logos-electromechanical/Arachnio/Arachnio/images/Arachnio-pinout.png

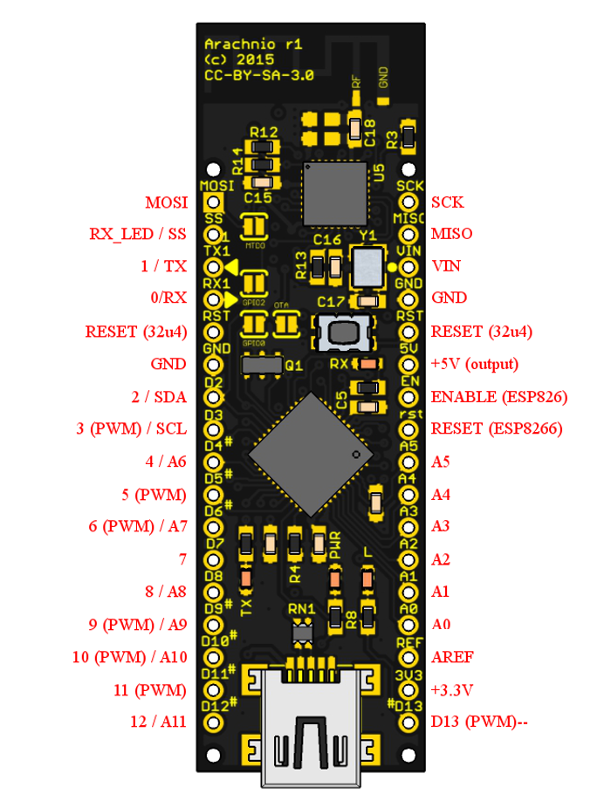
Arachnio/images/Arachnio-pinout.png
