logos-electromechanical/Arachnio/images/arachnio-proto-top.png

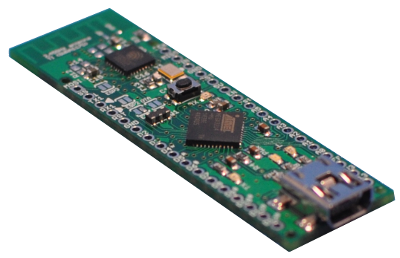
images/arachnio-proto-top.png
