logos-electromechanical/Arachnio/README.md

# Arachnio
An Arduino Micro variant with integrated WiFi
