logos-electromechanical/Arachnio/Arachnio/images/Arachnio-bot.jpg

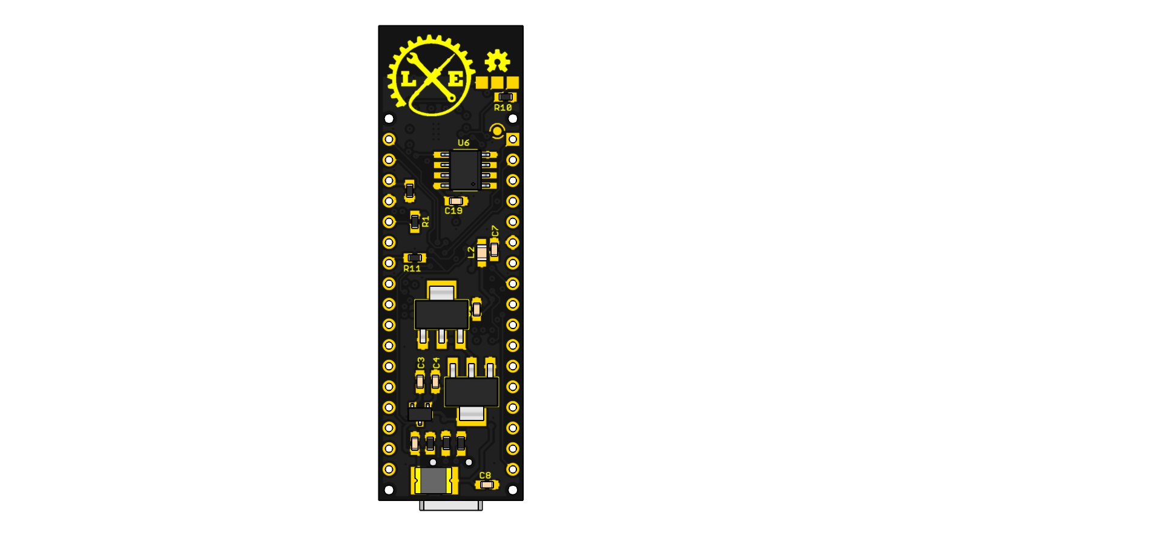
Arachnio/images/Arachnio-bot.jpg
