logos-electromechanical/Arachnio/Arachnio/images/Arachnio-iso-2.jpg

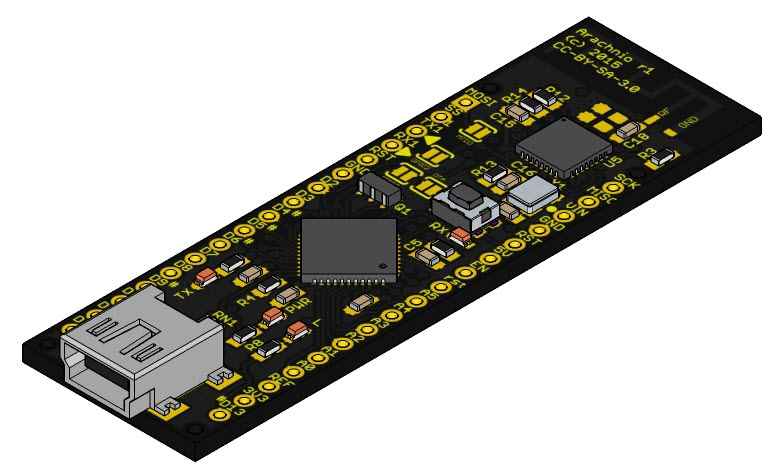
Arachnio/images/Arachnio-iso-2.jpg
