logos-electromechanical/Arachnio/Arachnio/images/Arachnio-iso.jpg

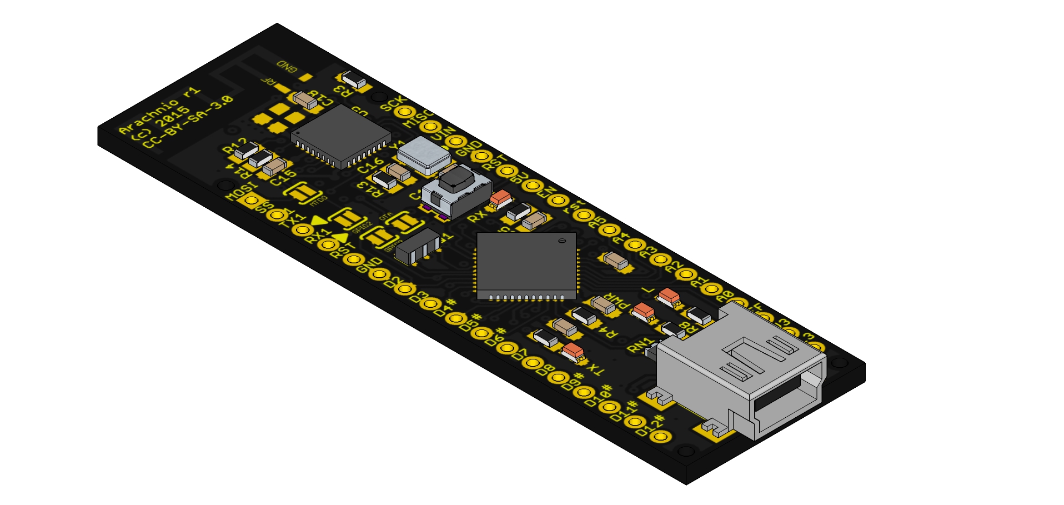
Arachnio/images/Arachnio-iso.jpg
