logos-electromechanical/Arachnio/Arachnio/images/Arachnio-pinout.jpg

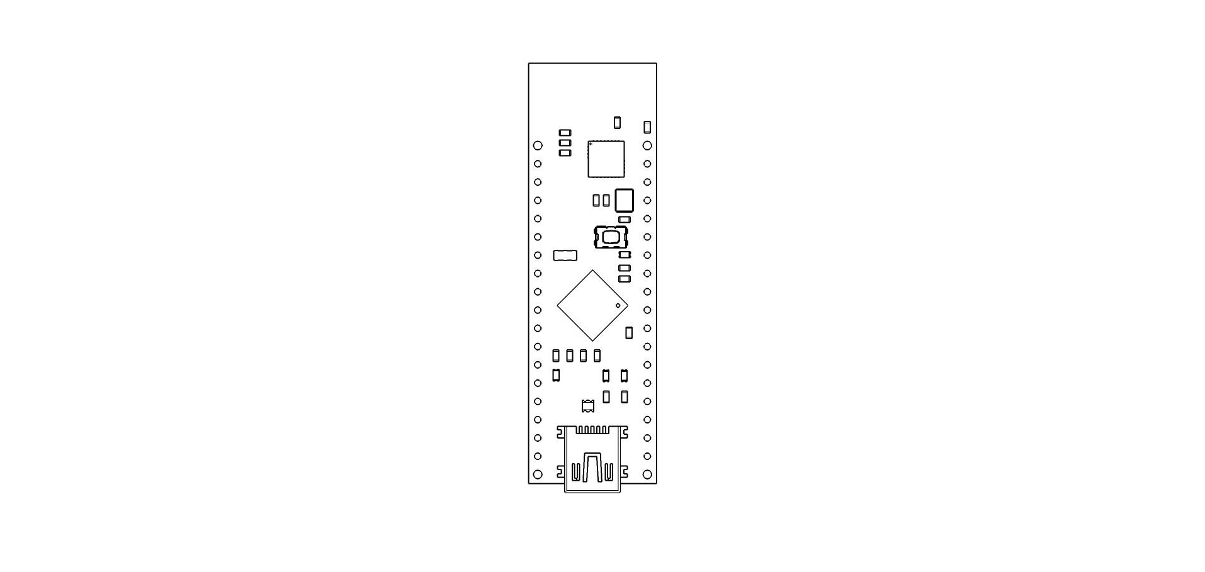
Arachnio/images/Arachnio-pinout.jpg
