logos-electromechanical/Arachnio/Arachnio/images/arachnio-single-top.jpg

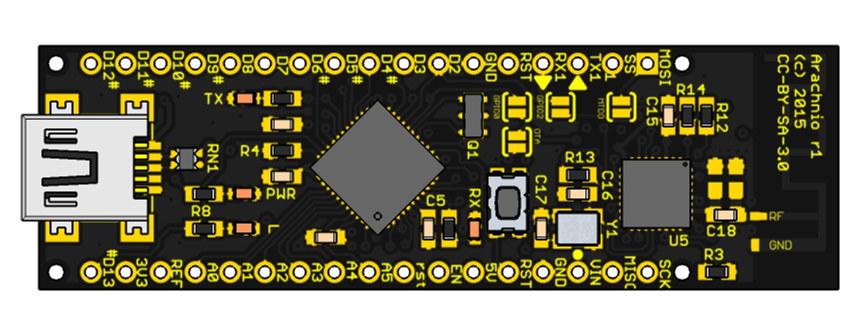
Arachnio/images/arachnio-single-top.jpg
