logos-electromechanical/Arachnio/Arachnio/images/eagleUp_Throwieduino-1_board_bottom.png

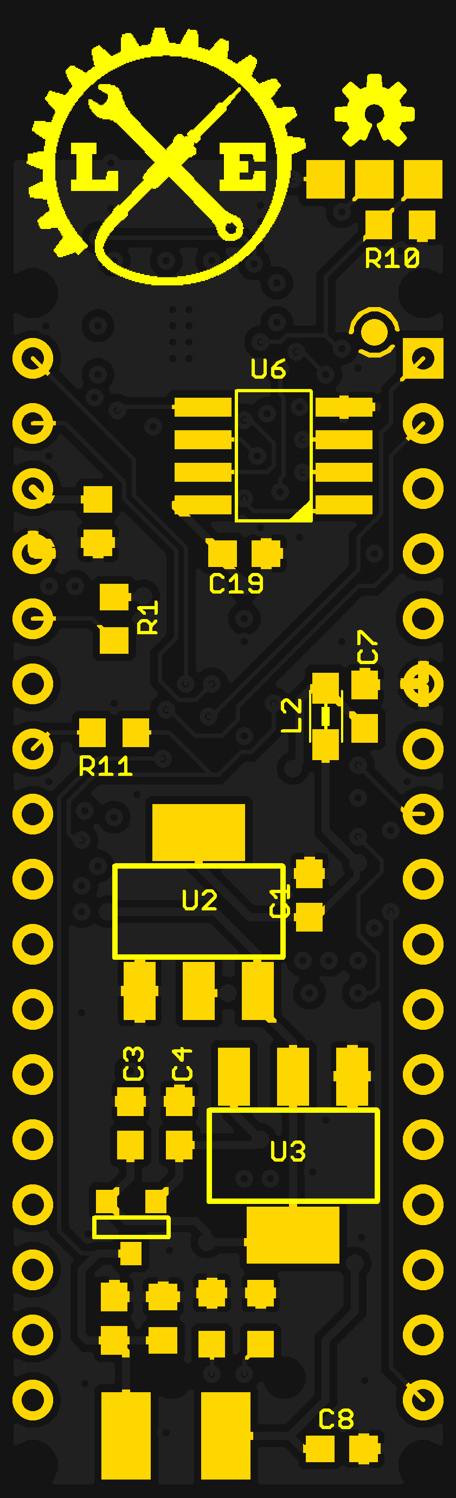
Arachnio/images/eagleUp_Throwieduino-1_board_bottom.png
