logos-electromechanical/Arachnio/Arachnio/images/eagleUp_Throwieduino-1_board_top.png

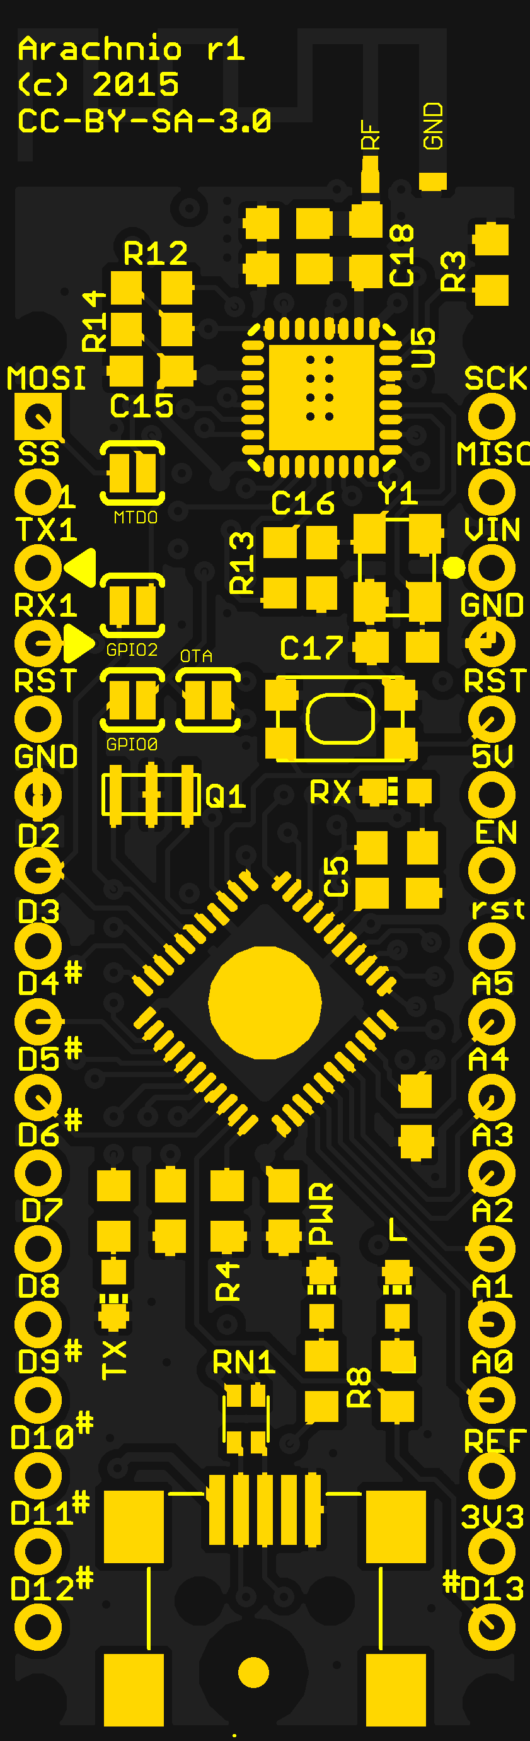
Arachnio/images/eagleUp_Throwieduino-1_board_top.png
