logos-electromechanical/Arachnio/Arachnode/images/Arachnode-iso.jpg

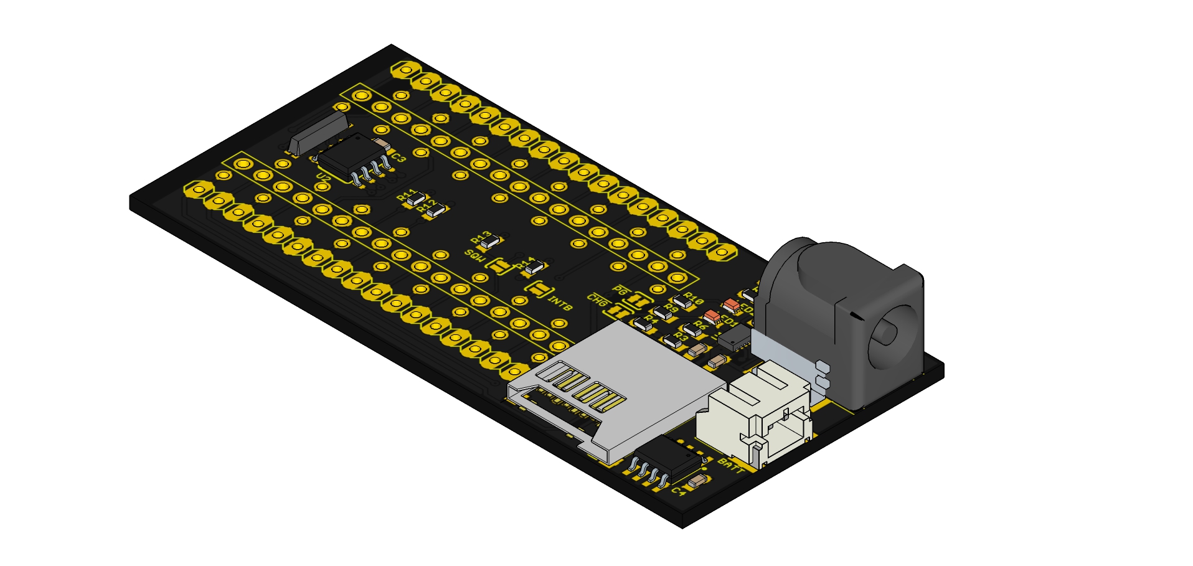
Arachnode/images/Arachnode-iso.jpg
