logos-electromechanical/Arachnio/Arachnode/images/Arachnode-top.jpg

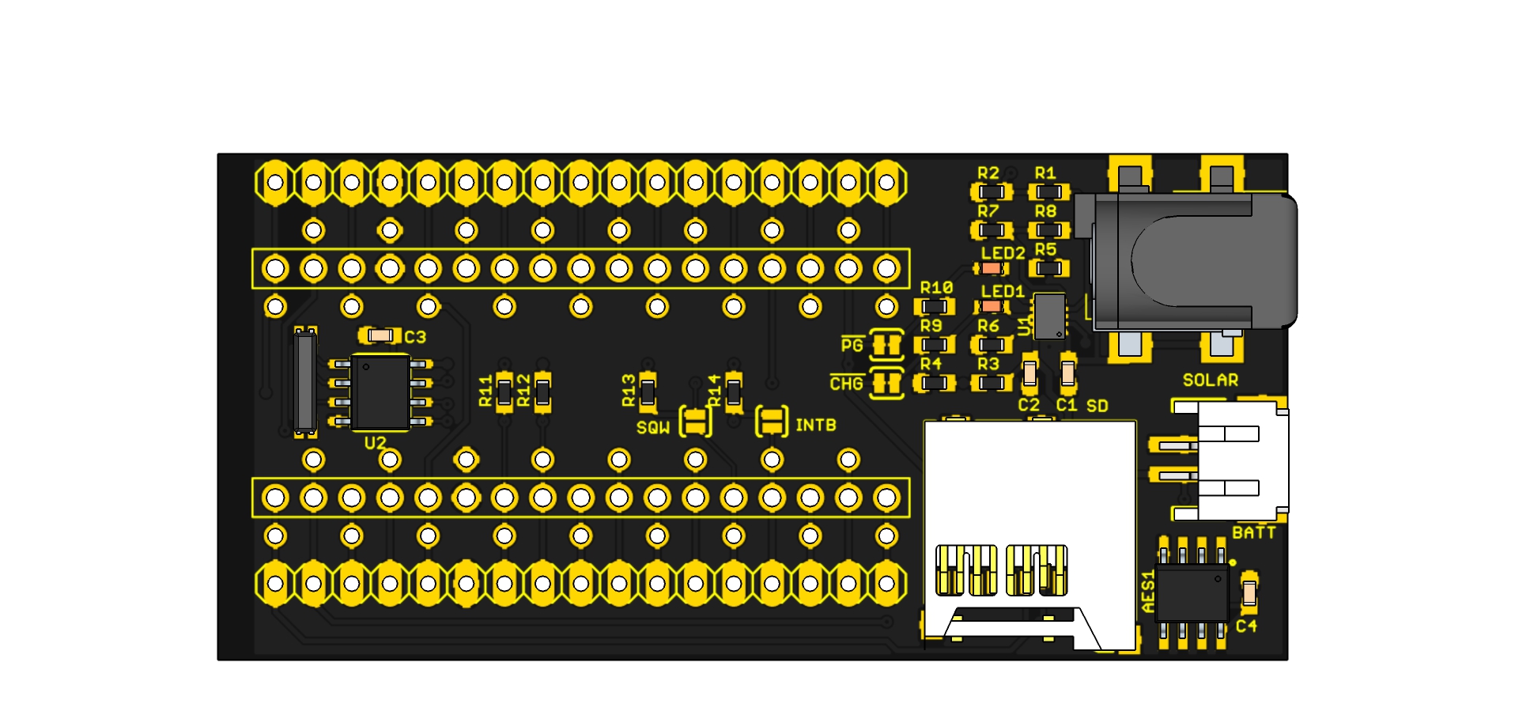
Arachnode/images/Arachnode-top.jpg
