logos-electromechanical/Arachnio/ArachnoProto/images/ArachnoProto-iso.jpg

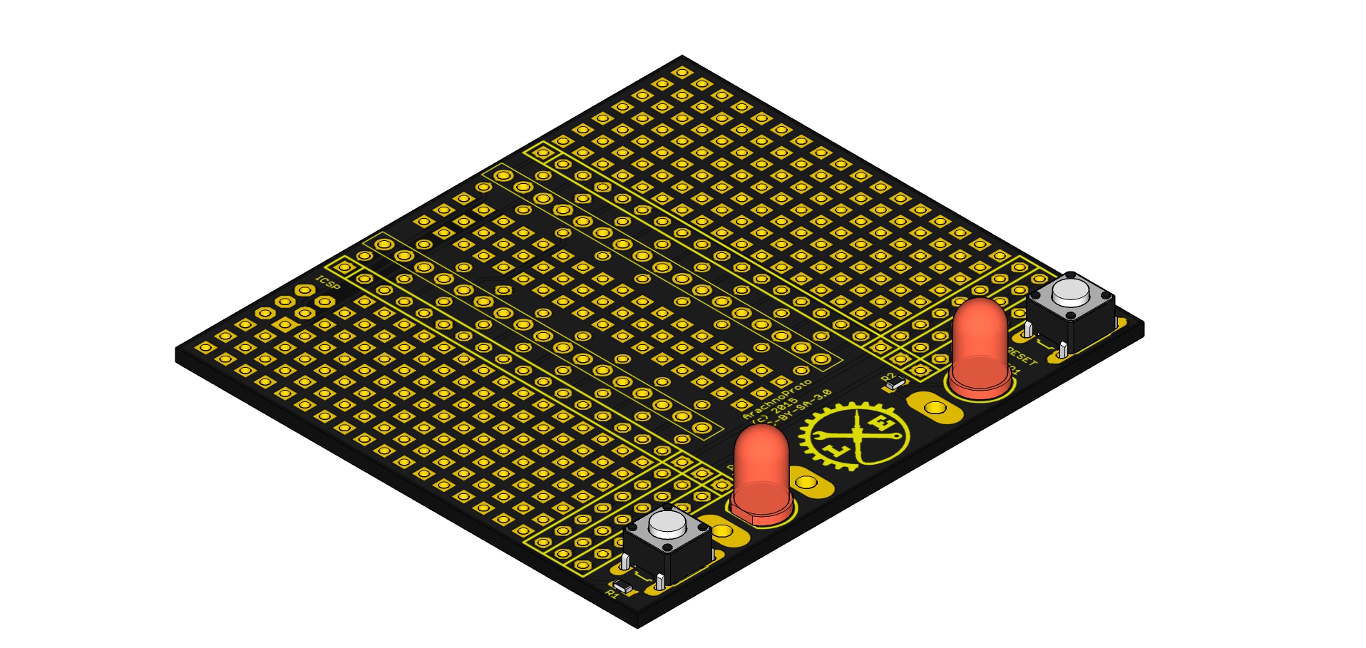
ArachnoProto/images/ArachnoProto-iso.jpg
