logos-electromechanical/Arachnio/ArachnoProto/images/ArachnoProto-top.jpg

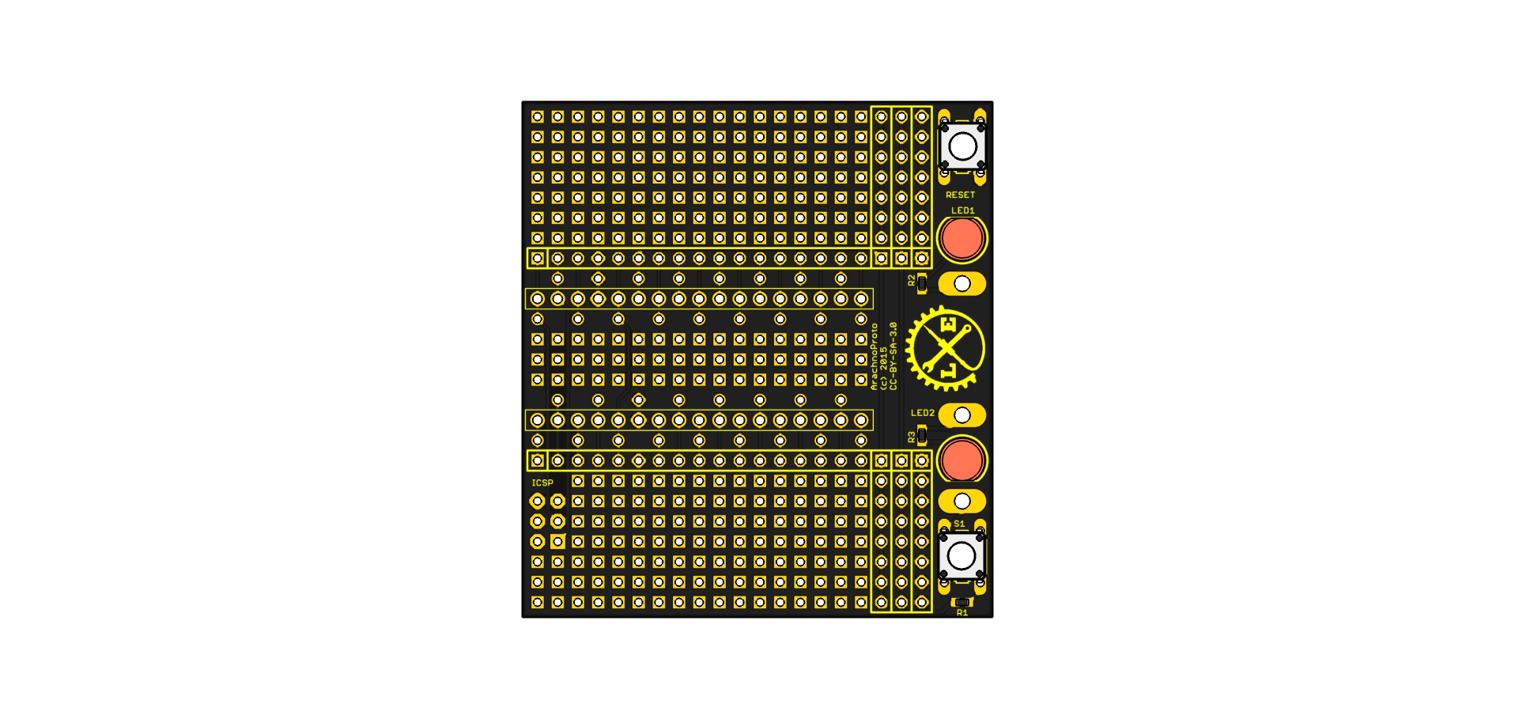
ArachnoProto/images/ArachnoProto-top.jpg
