logos-electromechanical/Arachnio/images/arachnio-double-top.png

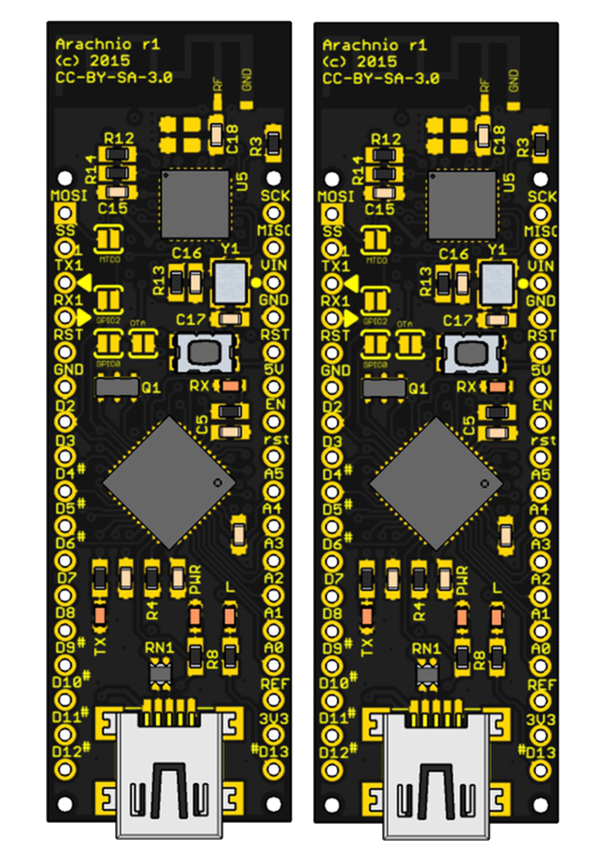
images/arachnio-double-top.png
