logos-electromechanical/Arachnio/images/arachnio-proto-bottom.png

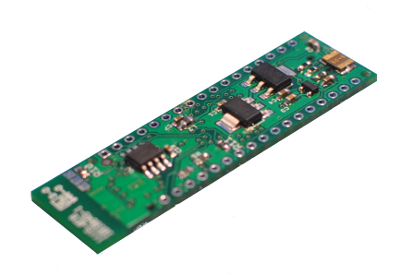
images/arachnio-proto-bottom.png
