logos-electromechanical/Arachnio/images/arachnode-rc-1.png

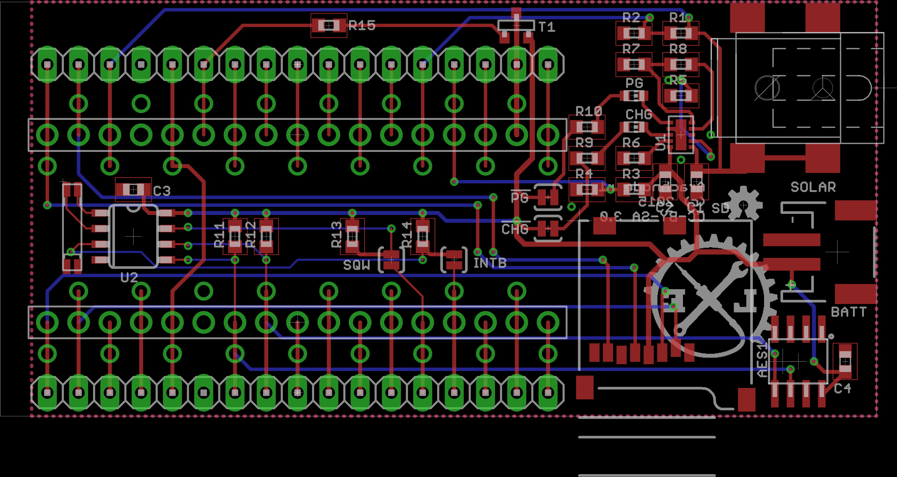
images/arachnode-rc-1.png
