logos-electromechanical/Arachnio/images/arachnoproto-rc-1.png

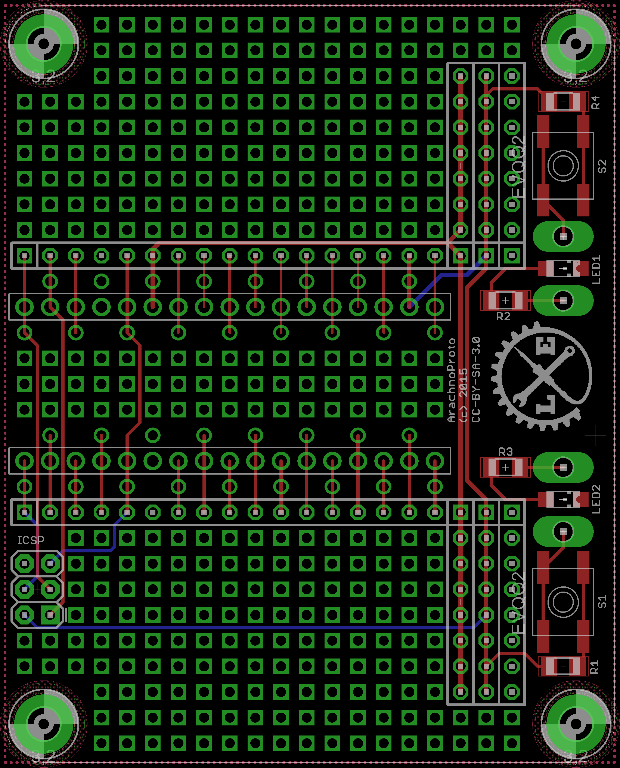
images/arachnoproto-rc-1.png
