logos-electromechanical/Arachnio/(list of files, cad)

Other CAD files:
Arachnio/hardware/eagleUp/Arachnio.skp
ArachnoProto/hardware/eagleUp/ArachnoProto.skp
Arachnode/hardware/eagleUp/Arachnode.skp
