logos-electromechanical/Arachnio/Arachnode/hardware/Arachnode.brd

## EAGLE design Arachnode/hardware/Arachnode.brd (2015-10-17)

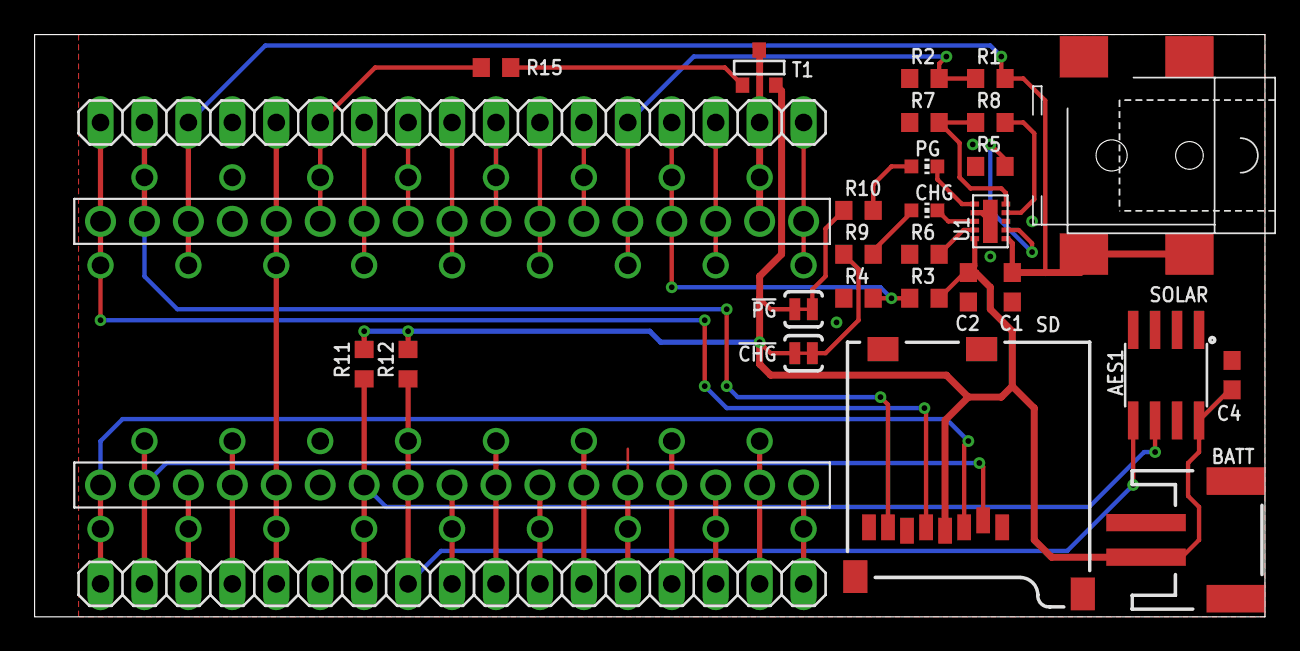
[picture p18: board Arachnode.brd from above]

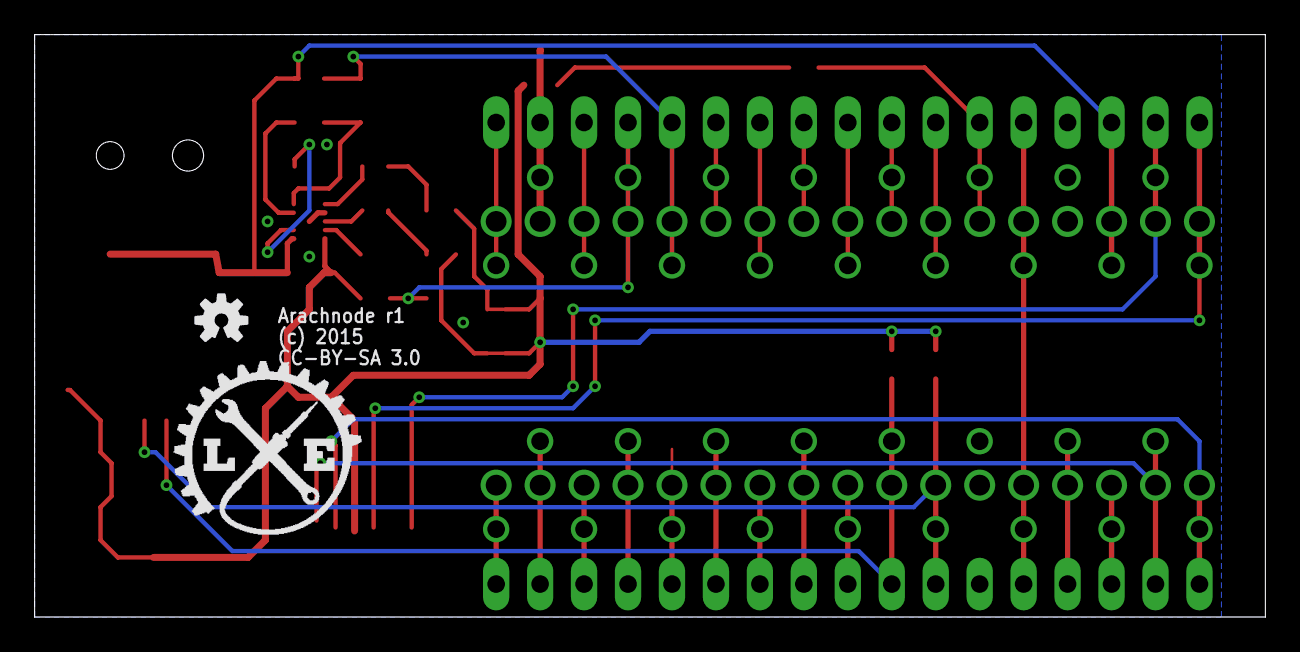
[picture p19: board Arachnode.brd from below]

Board: 2 copper layers, 71.1 x 33.7 mm, 32 parts (2 on the bottom side), 44 nets.

Parts:
!CHG!: JUMPER-PAD-2-NC_BY_TRACE; PAD-JUMPER-2-NC_BY_TRACE_YES_SILK
!PG!: JUMPER-PAD-2-NC_BY_TRACE; PAD-JUMPER-2-NC_BY_TRACE_YES_SILK
AES1: ATAES132; SOIC8
BATT: JST-2-SMD
C1, C2: 1.0uF; C0603
C4: 100n; C0603
CHG: CHIP-LED0603
J1, J2: PINHEAD-17-REV; 4UCONN-12573
JP1, JP2: 1X17
PG: CHIP-LED0603
R1, R3: 2M; R0603
R2, R4: 1M; R0603
R5: 820R; R0603
R6: 4K7; R0603
R7: 33k; R0603
R8: 68k; R0603
R9, R10: 10K; R0603
R11, R12, R15: 4k7; R0603
SD: USD-SOCKETNEW; MICRO-SD-SOCKET-PP
SOLAR: PJ002A-SMT
T1: SOT-23
U1: BQ24210; WSON-10
U$1: OSHW-LOGO-S
U$2: LOGO-SM

Connections:
3V3: J2.16, J2.33, JP2.16, T1.1
+5V: J2.6, J2.23, JP2.6, R15.2
A0: J2.14, J2.31, JP2.14, R3.1, R4.2
A1: J2.13, J2.30, JP2.13, R1.1, R2.2
A2: J2.12, J2.29, JP2.12
A3: J2.11, J2.28, JP2.11
A4: J2.10, J2.27, JP2.10
A5: J2.9, J2.26, JP2.9
AREF: J2.15, J2.32, JP2.15
D0: J1.4, J1.21, JP1.4
D1: J1.3, J1.20, JP1.3
D4: J1.9, J1.26, JP1.9
D5: J1.10, J1.27, JP1.10
D6: J1.11, J1.28, JP1.11
D7: J1.12, J1.29, JP1.12
ESP_RST: J2.8, J2.25, JP2.8
GND: AES1.4, BATT.1, BATT.NC1, BATT.NC2, C1.1, C2.1, C4.2, J1.6, J1.23, J2.4, J2.21, JP1.6, JP2.4, R2.1, R4.1, R5.1, R6.1, R7.1, SD.6, SD.CD1, SD.CD2, SD.GND1, SD.GND3, SOLAR.2, SOLAR.3, U1.3, U1.7, U1.PAD
IO8: J1.13, J1.30, JP1.13
IO9: J1.14, J1.31, JP1.14
IO10: J1.15, J1.32, JP1.15
IO11: J1.16, J1.33, JP1.16
IO12: J1.17, J1.34, JP1.17
IO13: J2.17, J2.34, JP2.17
MISO: J2.2, J2.19, JP2.2, SD.7
MOSI: J1.1, J1.18, JP1.1, SD.3
unnamed: R15.1, T1.3
unnamed: PG.A, R10.2
unnamed: R5.2, U1.2
unnamed: CHG.A, R9.2
unnamed: R6.2, U1.9
unnamed: R7.2, R8.1, U1.5
unnamed: PG.C, U1.6
unnamed: R8.2, U1.4
unnamed: CHG.C, U1.8
unnamed: !CHG!.1, R9.1
unnamed: !PG!.1, R10.1
RESET: J1.5, J1.22, J2.5, J2.22, JP1.5, JP2.5
SCK: J2.1, J2.18, JP2.1, SD.5
SCL: AES1.5, J1.8, J1.25, JP1.8, R12.1
SDA: AES1.6, J1.7, J1.24, JP1.7, R11.1
SS: J1.2, J1.19, JP1.2, SD.2
TOUT: J2.7, J2.24, JP2.7
VIN: C1.2, J2.3, J2.20, JP2.3, R1.2, SOLAR.1A, SOLAR.1B, U1.1
V_BATT: !CHG!.2, !PG!.2, AES1.8, BATT.2, C2.2, C4.1, R3.2, R11.2, R12.2, SD.4, T1.2, U1.10
