logos-electromechanical/Arachnio/ArachnioDue/hardware/ArachnioDue.brd

## EAGLE design ArachnioDue/hardware/ArachnioDue.brd (2015-08-19)

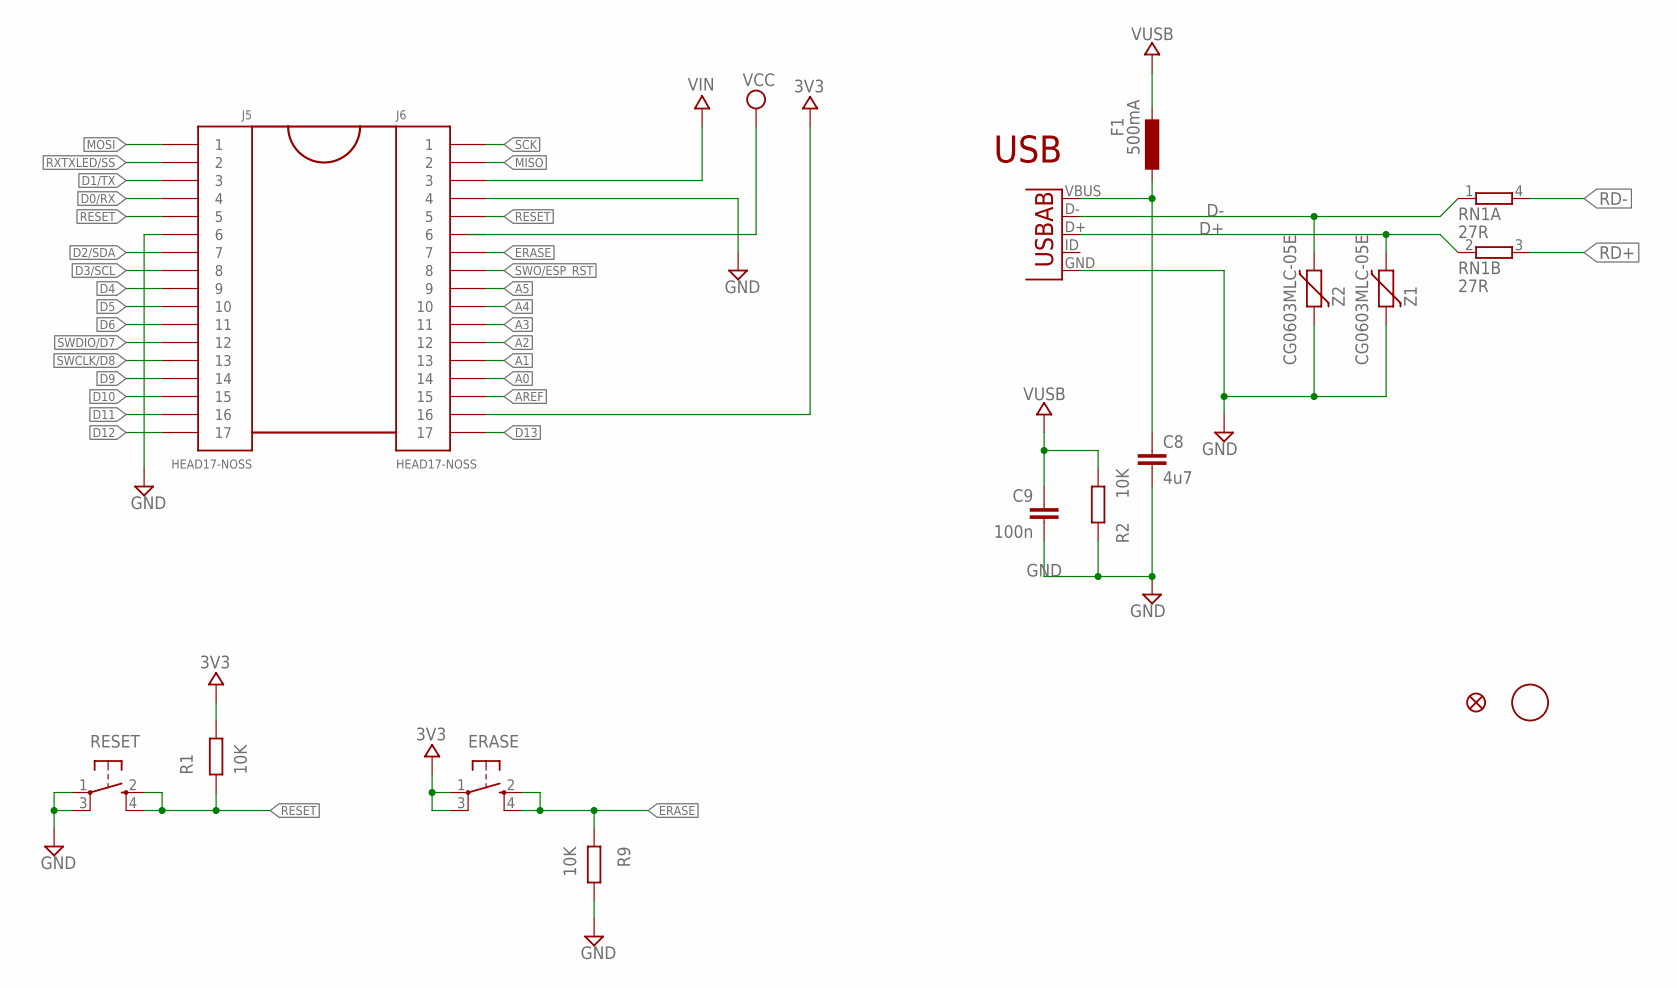
[picture p20: schematic ArachnioDue.sch, sheet 1]

Parts:
C8: 4u7; C0603; PARTNO generic MLCC:4u7/25V/0603
C9: 100n; C0603; PARTNO generic MLCC:100n/50V/0603
CN1: USB-AB; USB-AB-MICRO-SMD; PARTNO 10104111-0001LF
ERASE: SPST_TACT-KMR2; KMR2; PARTNO KMR221NG
F1: 500mA; L1812; PARTNO MF-MSMF050-2
J5: HEAD17-NOSS; PARTNO PREC017SAAN-RC
J6: HEAD17-NOSS; HEAD17-NOSS-1; PARTNO PREC017SAAN-RC
R1, R2, R9: 10K; R0402; PARTNO generic resistor:10K/0402
RESET: SPST_TACT-KMR2; KMR2; PARTNO KMR221NG
RN1: 27R; EXBV4V; PARTNO EXB-V4V270JV
U$37: FIDUCIALMOUNT; FIDUCIA-MOUNT
U$53: FIDUCIAL1X2; FIDUCIAL-1X2
Z1, Z2: CG0603MLC-05E; CT/CN0603; PARTNO CG0603MLC-05E

Connections:
3V3: ERASE.1, ERASE.3 (P1), J6.16, R1.1; also elsewhere on the board
A0: J6.14; also elsewhere on the board
A1: J6.13; also elsewhere on the board
A2: J6.12; also elsewhere on the board
A3: J6.11; also elsewhere on the board
A4: J6.10; also elsewhere on the board
A5: J6.9; also elsewhere on the board
AREF: J6.15; also elsewhere on the board
D0/RX: J5.4; also elsewhere on the board
D1/TX: J5.3; also elsewhere on the board
D2/SDA: J5.7; also elsewhere on the board
D3/SCL: J5.8; also elsewhere on the board
D4: J5.9; also elsewhere on the board
D5: J5.10; also elsewhere on the board
D6: J5.11; also elsewhere on the board
D9: J5.14; also elsewhere on the board
D10: J5.15; also elsewhere on the board
D11: J5.16; also elsewhere on the board
D12: J5.17; also elsewhere on the board
D13: J6.17; also elsewhere on the board
D+: CN1.D+, RN1.2 (1), Z1.1
D-: CN1.D-, RN1.1, Z2.1
ERASE: ERASE.2 (S), ERASE.4 (S1), J6.7, R9.2; also elsewhere on the board
GND: C8.2, C9.2, CN1.GND, J5.6, J6.4, R2.1, R9.1, RESET.1, RESET.3 (P1), Z1.2, Z2.2; also elsewhere on the board
MISO: J6.2; also elsewhere on the board
MOSI: J5.1; also elsewhere on the board
RD+: RN1.3 (2); also elsewhere on the board
RD-: RN1.4 (2); also elsewhere on the board
RESET: J5.5, J6.5, R1.2, RESET.2 (S), RESET.4 (S1); also elsewhere on the board
RXTXLED/SS: J5.2; also elsewhere on the board
SCK: J6.1; also elsewhere on the board
SWCLK/D8: J5.13; also elsewhere on the board
SWDIO/D7: J5.12; also elsewhere on the board
SWO/ESP_RST: J6.8; also elsewhere on the board
VCC: J6.6; also elsewhere on the board
VIN: J6.3; also elsewhere on the board
VUSB: C9.1, F1.2, R2.2; also elsewhere on the board
VUSBD: C8.1, CN1.VBUS, F1.1

Notes on the sheet:
USB

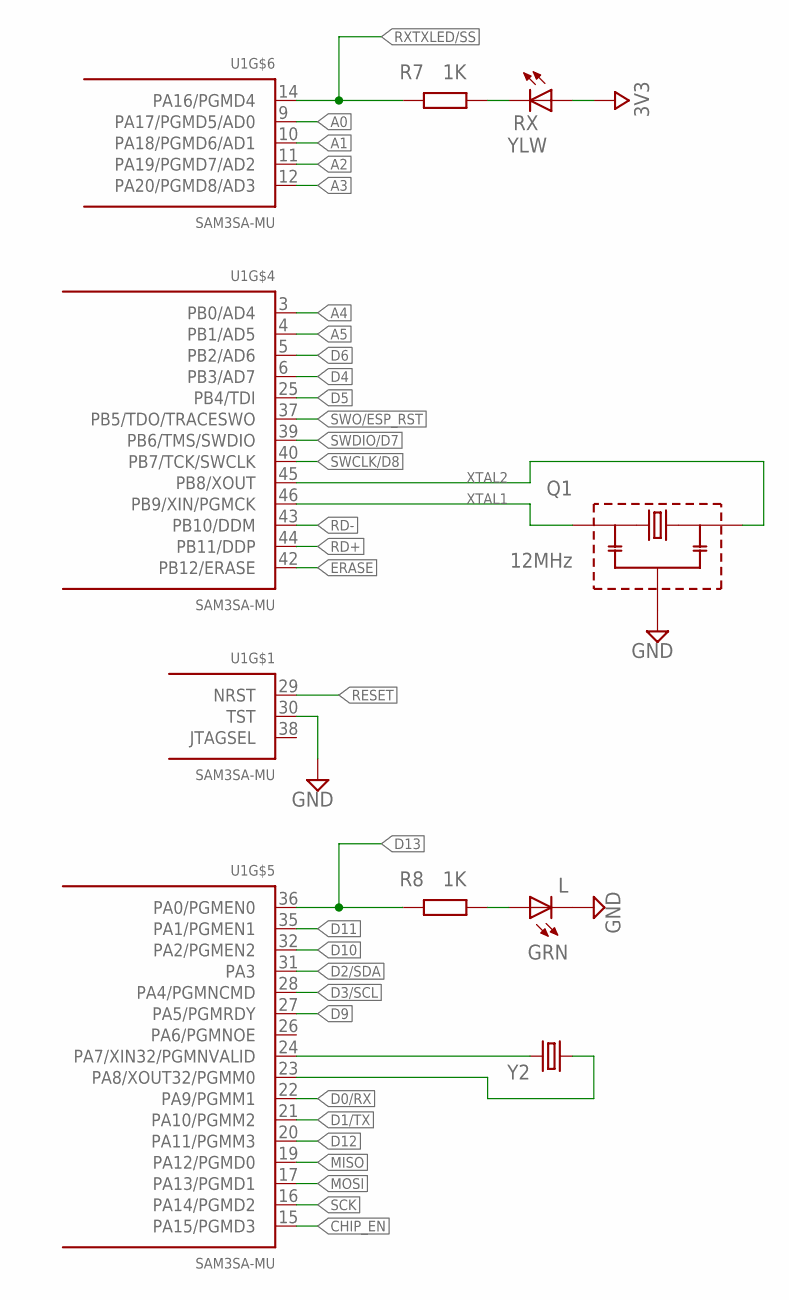
[picture p21: schematic ArachnioDue.sch, sheet 2]

Parts:
L: GRN; CHIP-LED0603; PARTNO LTST-C191KGKT
Q1: 12MHz; PRQC; PARTNO PRQC12.00CR1010V00L
R7, R8: 1K; R0402; PARTNO generic resistor:1K/0402
RX: YLW; CHIP-LED0603; PARTNO LTST-C191KSKT
U1: SAM3SA-MU; QFN48; PARTNO ATSAM4S2AA-MU
Y2: CRYSTALEPSONMC146; CRYSTAL-32KHZ-SMD_EPSON_MC146; PARTNO MC-146 32.768KA-AC3

Connections:
3V3: RX.A; also elsewhere on the board
A0: U1.9 (PA17/PGMD5/AD0); also elsewhere on the board
A1: U1.10 (PA18/PGMD6/AD1); also elsewhere on the board
A2: U1.11 (PA19/PGMD7/AD2); also elsewhere on the board
A3: U1.12 (PA20/PGMD8/AD3); also elsewhere on the board
A4: U1.3 (PB0/AD4); also elsewhere on the board
A5: U1.4 (PB1/AD5); also elsewhere on the board
CHIP_EN: U1.15 (PA15/PGMD3); also elsewhere on the board
D0/RX: U1.22 (PA9/PGMM1); also elsewhere on the board
D1/TX: U1.21 (PA10/PGMM2); also elsewhere on the board
D2/SDA: U1.31 (PA3); also elsewhere on the board
D3/SCL: U1.28 (PA4/PGMNCMD); also elsewhere on the board
D4: U1.6 (PB3/AD7); also elsewhere on the board
D5: U1.25 (PB4/TDI); also elsewhere on the board
D6: U1.5 (PB2/AD6); also elsewhere on the board
D9: U1.27 (PA5/PGMRDY); also elsewhere on the board
D10: U1.32 (PA2/PGMEN2); also elsewhere on the board
D11: U1.35 (PA1/PGMEN1); also elsewhere on the board
D12: U1.20 (PA11/PGMM3); also elsewhere on the board
D13: R8.1, U1.36 (PA0/PGMEN0); also elsewhere on the board
ERASE: U1.42 (PB12/ERASE); also elsewhere on the board
GND: L.C, Q1.P$2 (2), U1.30 (TST); also elsewhere on the board
MISO: U1.19 (PA12/PGMD0); also elsewhere on the board
MOSI: U1.17 (PA13/PGMD1); also elsewhere on the board
unnamed: U1.23 (PA8/XOUT32/PGMM0), Y2.P$2 (1)
unnamed: R7.2, RX.C
unnamed: U1.24 (PA7/XIN32/PGMNVALID), Y2.P$1 (2)
unnamed: L.A, R8.2
RD+: U1.44 (PB11/DDP); also elsewhere on the board
RD-: U1.43 (PB10/DDM); also elsewhere on the board
RESET: U1.29 (NRST); also elsewhere on the board
RXTXLED/SS: R7.1, U1.14 (PA16/PGMD4); also elsewhere on the board
SCK: U1.16 (PA14/PGMD2); also elsewhere on the board
SWCLK/D8: U1.40 (PB7/TCK/SWCLK); also elsewhere on the board
SWDIO/D7: U1.39 (PB6/TMS/SWDIO); also elsewhere on the board
SWO/ESP_RST: U1.37 (PB5/TDO/TRACESWO); also elsewhere on the board
XTAL1: Q1.P$3 (3), U1.46 (PB9/XIN/PGMCK)
XTAL2: Q1.P$1 (1), U1.45 (PB8/XOUT)

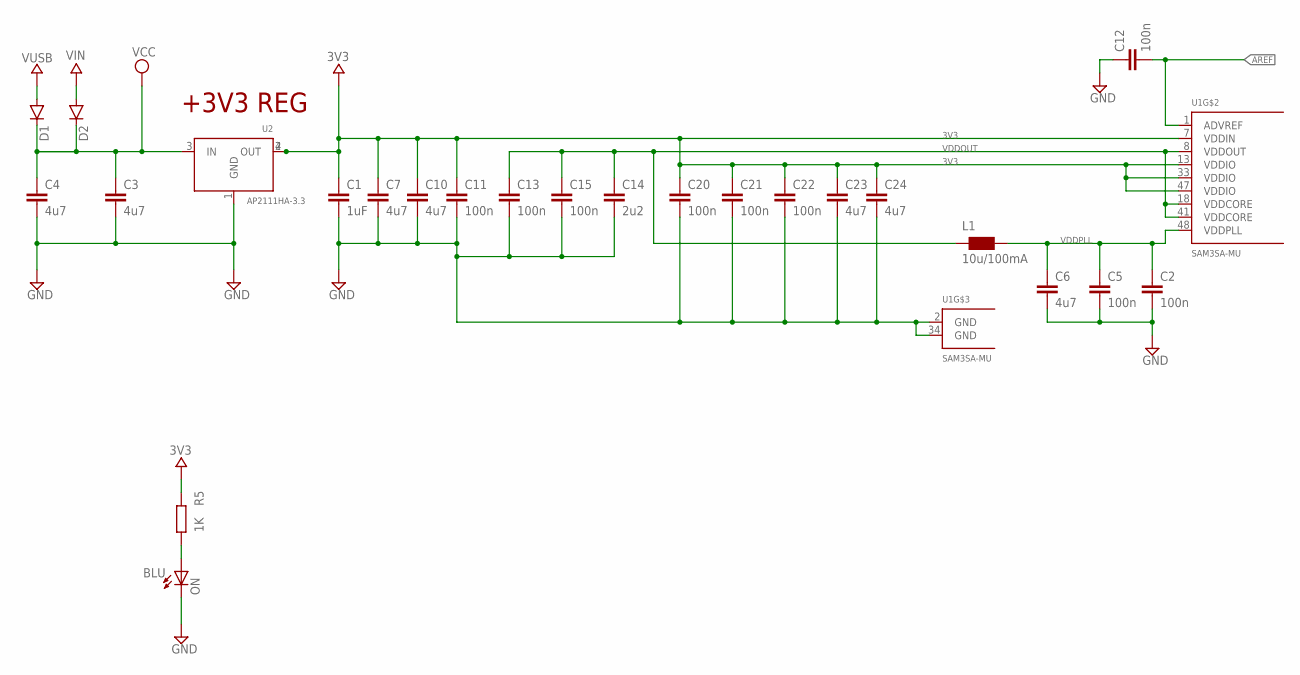
[picture p22: schematic ArachnioDue.sch, sheet 3]

Parts:
C1: 1uF; C0603; PARTNO generic MLCC:1u/25V/0603
C2, C12: 100n; C0402; PARTNO generic MLCC:100n/16V/0402
C3, C4: 4u7; C0603; PARTNO generic MLCC:4u7/25V/0603
C5, C11, C13, C15, C20, C21, C22: 100n; C0402; VOLTAGE 16V; PARTNO generic MLCC:100n/16V/0402
C6, C7, C10, C23, C24: 4u7; C0603; VOLTAGE 10V; PARTNO generic MLCC:4u7/10V/0603
C14: 2u2; C0603; VOLTAGE 6V3; PARTNO generic MLCC:2u2/6V3/0603
D1, D2: DIODESOD123; SOD-123; PARTNO CDBW140-G
L1: 10u/100mA; 0805; PARTNO MLZ2012N100LT000
ON: BLU; CHIP-LED0603; PARTNO LB Q39G-L2N2-35-1
R5: 1K; R0402; PARTNO generic resistor:1K/0402
U1: SAM3SA-MU; QFN48; PARTNO ATSAM4S2AA-MU
U2: AP2111HA-3.3; SOT223; PARTNO AP2111H-3.3TRG1

Connections:
3V3: C1.1, C7.1, C10.1, C11.1, C20.1, C21.1, C22.1, C23.1, C24.1, R5.1, U1.7 (VDDIN), U1.13 (VDDIO), U1.33 (VDDIO), U1.47 (VDDIO), U2.2 (OUT), U2.4 (OUT); also elsewhere on the board
AREF: C12.2, U1.1 (ADVREF); also elsewhere on the board
GND: C1.2, C2.2, C3.2, C4.2, C5.2, C6.2, C7.2, C10.2, C11.2, C12.1, C13.2, C14.2, C15.2, C20.2, C21.2, C22.2, C23.2, C24.2, ON.C, U1.2 (GND), U1.34 (GND), U2.1 (GND); also elsewhere on the board
unnamed: ON.A, R5.2
VCC: C3.1, C4.1, D1.C, D2.C, U2.3 (IN); also elsewhere on the board
VDDOUT: C13.1, C14.1, C15.1, L1.1, U1.8 (VDDOUT), U1.18 (VDDCORE), U1.41 (VDDCORE)
VDDPLL: C2.1, C5.1, C6.1, L1.2, U1.48 (VDDPLL)
VIN: D2.A; also elsewhere on the board
VUSB: D1.A; also elsewhere on the board

Notes on the sheet:
+3V3 REG

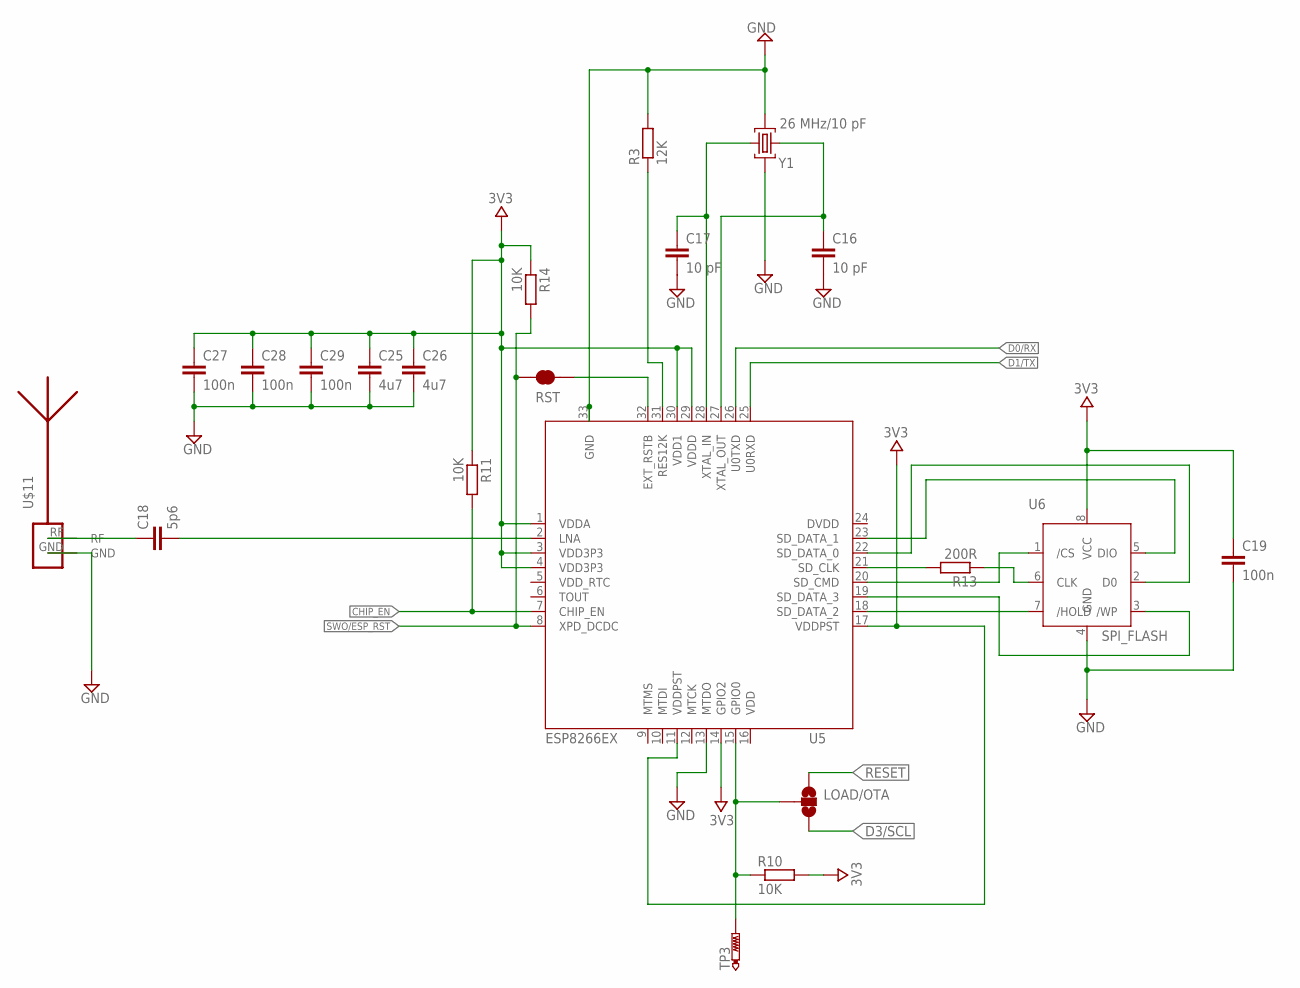
[picture p23: schematic ArachnioDue.sch, sheet 4]

Parts:
C16, C17: 10 pF; C0402
C18: 5p6; C0402
C19: 100n; C0402; PARTNO generic MLCC:100n/16V/0402
C25, C26: 4u7; C0603; VOLTAGE 10V; PARTNO generic MLCC:4u7/10V/0603
C27, C28, C29: 100n; C0402; VOLTAGE 16V; PARTNO generic MLCC:100n/16V/0402
LOAD/OTA: JUMPER-PAD-3-NOYES_SILK; PAD-JUMPER-3-NO_YES_SILK
R3: 12K; R0402; PARTNO generic resistor:12K/0402
R10, R11, R14: 10K; R0402; PARTNO generic resistor:10K/0402
R13: 200R; R0402; PARTNO generic resistor:200R/0402
RST: JUMPER-PAD-2-NC_BY_TRACE; PAD-JUMPER-2-NC_BY_TRACE_YES_SILK; PARTNO MCR03ERTJ000
TP3: PTR1TP15SQ; TP15SQ
U5: ESP8266EX; QFN32; PARTNO ESP8266EX
U6: SPI_FLASH; SOIC-8; PARTNO SST25VF512A-33-4C-SAE
U$11: ANTENNA_1RIGHT; SWRA117D_RIGHT; PARTNO *
Y1: 26 MHz/10 pF; CRYSTAL-3.2-2.5; PARTNO 403C11A26M00000

Connections:
3V3: C19.1, C25.1, C26.1, C27.1, C28.1, C29.1, R10.2, R11.1, R14.1, U5.1 (VDDA), U5.3 (VDD3P3), U5.4 (VDD3P3), U5.11 (VDDPST), U5.14 (GPIO2), U5.17 (VDDPST), U5.29 (VDDD), U5.30 (VDD1), U6.8 (VCC); also elsewhere on the board
CHIP_EN: R11.2, U5.7 (CHIP_EN); also elsewhere on the board
D0/RX: U5.26 (U0TXD); also elsewhere on the board
D1/TX: U5.25 (U0RXD); also elsewhere on the board
D3/SCL: LOAD/OTA.3; also elsewhere on the board
DVDD: U5.24 (DVDD)
GND: C16.2, C17.2, C19.2, C25.2, C26.2, C27.2, C28.2, C29.2, R3.2, U5.13 (MTDO), U5.33 (GND), U6.4 (GND), U$11.GND, Y1.2 (GND), Y1.4 (GND); also elsewhere on the board
unnamed: LOAD/OTA.2, R10.1, TP3.TP, U5.15 (GPIO0)
unnamed: C17.1, U5.28 (XTAL_IN), Y1.1 (C1)
unnamed: C16.1, U5.27 (XTAL_OUT), Y1.3 (C2)
unnamed: C18.1, U$11.RF
unnamed: R3.1, U5.31 (RES12K)
unnamed: RST.1, U5.32 (EXT_RSTB)
unnamed: R13.2, U5.21 (SD_CLK)
unnamed: R13.1, U6.6 (CLK)
unnamed: U5.20 (SD_CMD), U6.1 (/CS)
unnamed: U5.18 (SD_DATA_2), U6.7 (/HOLD)
unnamed: U5.19 (SD_DATA_3), U6.3 (/WP)
unnamed: U5.23 (SD_DATA_1), U6.5 (DIO)
unnamed: U5.22 (SD_DATA_0), U6.2 (D0)
unnamed: C18.2, U5.2 (LNA)
RESET: LOAD/OTA.1; also elsewhere on the board
SWO/ESP_RST: R14.2, RST.2, U5.8 (XPD_DCDC); also elsewhere on the board
VDD: U5.16 (VDD)
VDD_RTC: U5.5 (VDD_RTC)

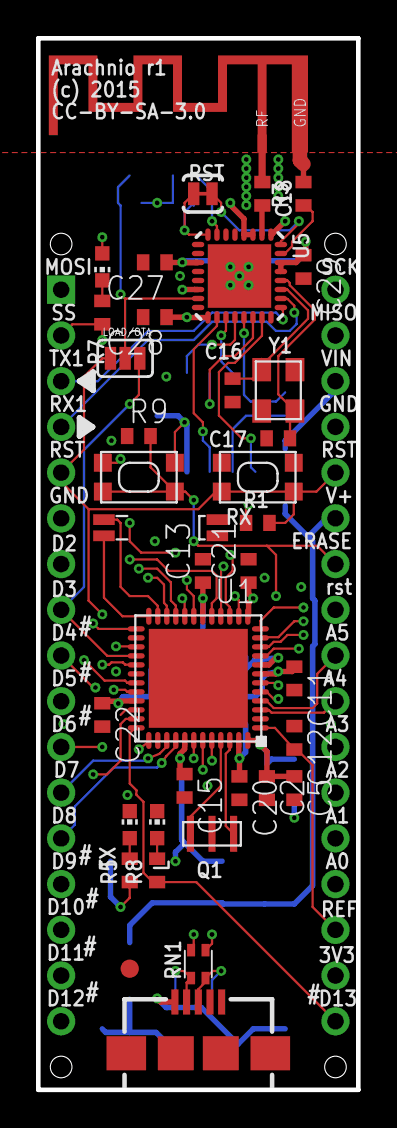
[picture p24: board ArachnioDue.brd from above]

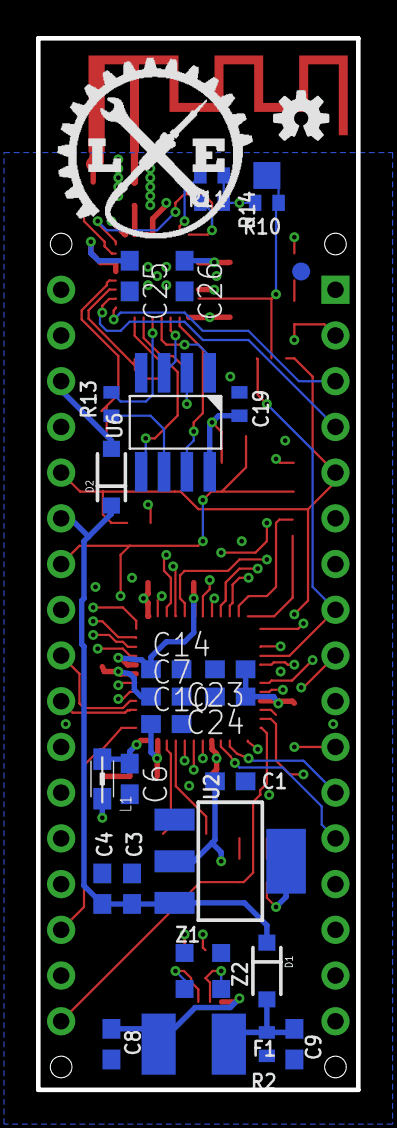
[picture p25: board ArachnioDue.brd from below]

Board: 4 copper layers, 17.8 x 58.4 mm, 70 parts (31 on the bottom side), 62 nets.

Other parts of the board:
U$1: LOGO-SM
U$12: OSHW-LOGO-S
