logos-electromechanical/Arachnio/Arachnio/hardware/Arachnio.brd

## EAGLE design Arachnio/hardware/Arachnio.brd (2015-05-03)

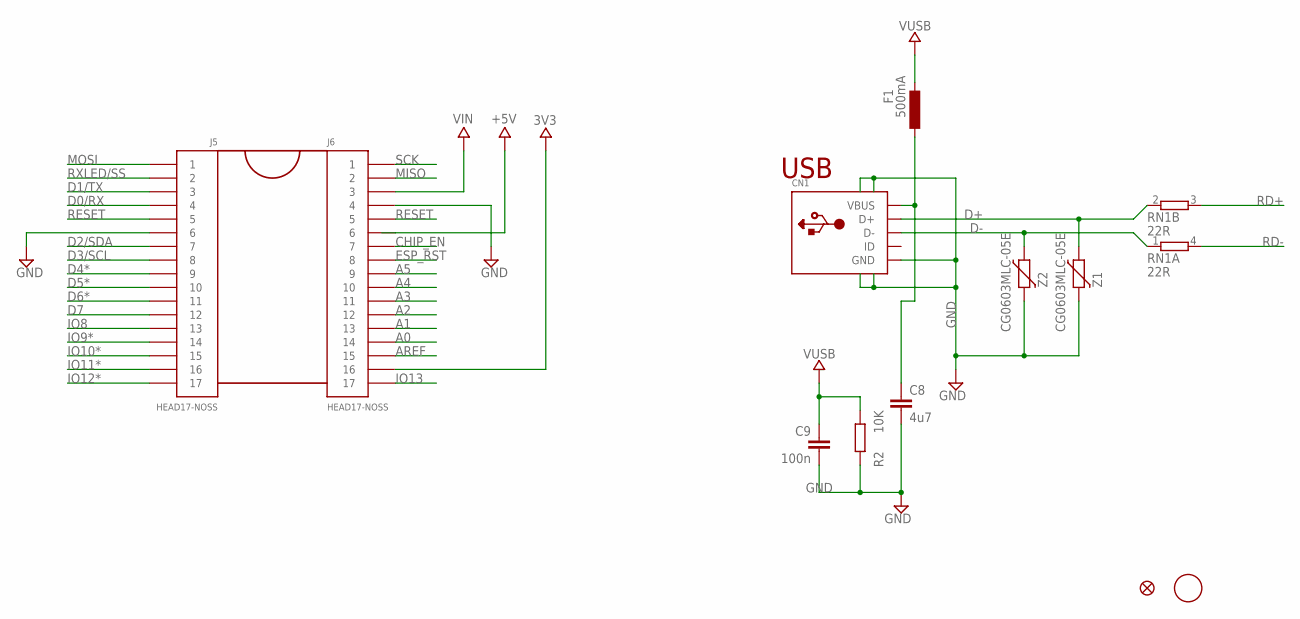
[picture p26: schematic Arachnio.sch, sheet 1]

Parts:
C8: 4u7; C0603; PARTNO CL10A475KA8NQNC
C9: 100n; C0603; PARTNO CC0603ZRY5V9BB104
CN1: USBMINIB; USB-MINIB; PARTNO USB-M26FTR
F1: 500mA; L1812; PARTNO MF-MSMF050-2
J5: HEAD17-NOSS; PARTNO PREC017SAAN-RC
J6: HEAD17-NOSS; HEAD17-NOSS-1; PARTNO PREC017SAAN-RC
R2: 10K; R0603; PARTNO RNCP0603FTD10K0
RN1: 22R; EXBV4V; PARTNO EXB-V4V220JV
U$37: FIDUCIALMOUNT; FIDUCIA-MOUNT
U$53: FIDUCIAL1X2; FIDUCIAL-1X2
Z1, Z2: CG0603MLC-05E; CT/CN0603; PARTNO CG0603MLC-05E

Connections:
3V3: J6.16; also elsewhere on the board
+5V: J6.6; also elsewhere on the board
A0: J6.14; also elsewhere on the board
A1: J6.13; also elsewhere on the board
A2: J6.12; also elsewhere on the board
A3: J6.11; also elsewhere on the board
A4: J6.10; also elsewhere on the board
A5: J6.9; also elsewhere on the board
AREF: J6.15; also elsewhere on the board
CHIP_EN: J6.7; also elsewhere on the board
D0/RX: J5.4; also elsewhere on the board
D1/TX: J5.3; also elsewhere on the board
D2/SDA: J5.7; also elsewhere on the board
D3/SCL: J5.8; also elsewhere on the board
D4*: J5.9; also elsewhere on the board
D5*: J5.10; also elsewhere on the board
D6*: J5.11; also elsewhere on the board
D7: J5.12; also elsewhere on the board
D+: CN1.D+, RN1.2 (1), Z1.1
D-: CN1.D-, RN1.1, Z2.1
ESP_RST: J6.8; also elsewhere on the board
GND: C8.2, C9.2, CN1.GND, CN1.GND1 (SHIELD), CN1.GND2 (SHIELD), CN1.GND3 (SHIELD), CN1.GND4 (SHIELD), J5.6, J6.4, R2.1, Z1.2, Z2.2; also elsewhere on the board
IO8: J5.13; also elsewhere on the board
IO9*: J5.14; also elsewhere on the board
IO10*: J5.15; also elsewhere on the board
IO11*: J5.16; also elsewhere on the board
IO12*: J5.17; also elsewhere on the board
IO13: J6.17; also elsewhere on the board
MISO: J6.2; also elsewhere on the board
MOSI: J5.1; also elsewhere on the board
RD+: RN1.3 (2); also elsewhere on the board
RD-: RN1.4 (2); also elsewhere on the board
RESET: J5.5, J6.5; also elsewhere on the board
RXLED/SS: J5.2; also elsewhere on the board
SCK: J6.1; also elsewhere on the board
VIN: J6.3; also elsewhere on the board
VUSB: C9.1, F1.2, R2.2; also elsewhere on the board
VUSBD: C8.1, CN1.VBUS, F1.1

Notes on the sheet:
USB

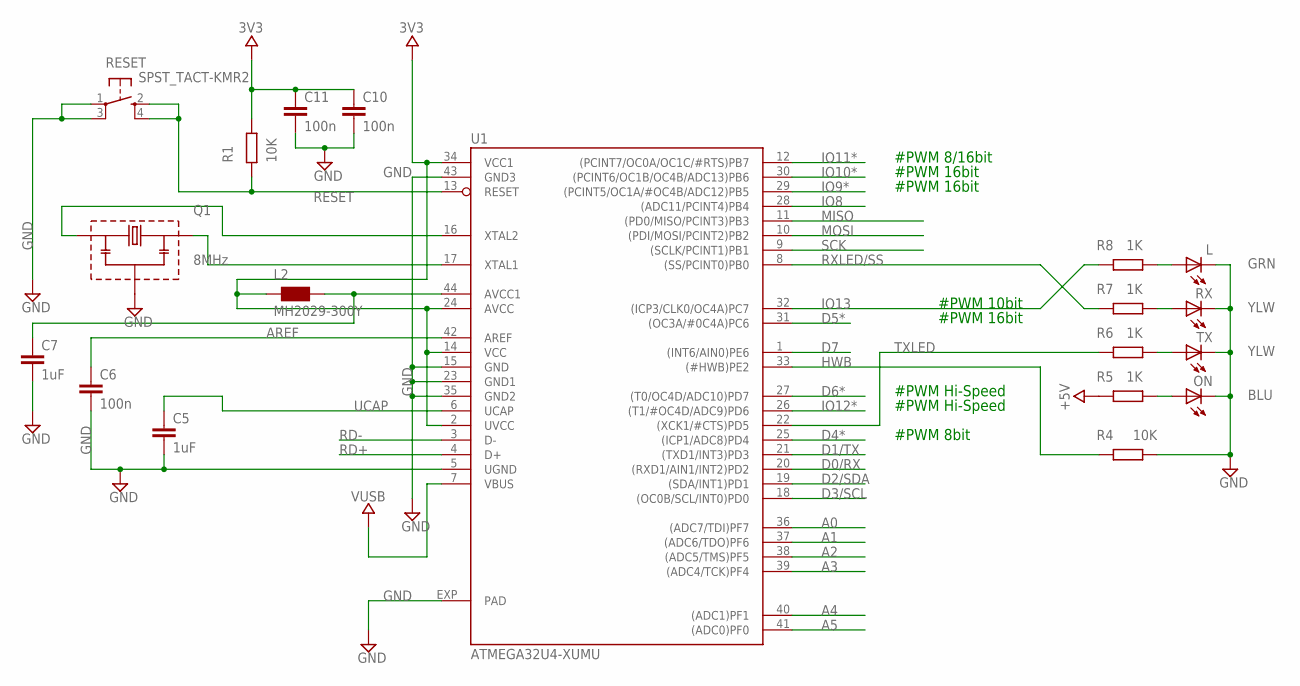
[picture p27: schematic Arachnio.sch, sheet 2]

Parts:
C5, C7: 1uF; C0603; PARTNO C0603C105K3PACTU
C6, C10, C11: 100n; C0603; PARTNO CC0603ZRY5V9BB104
L: GRN; CHIP-LED0603; PARTNO LTST-C191KGKT
L2: MH2029-300Y; 0805; PARTNO MH2029-300Y
ON: BLU; CHIP-LED0603; PARTNO LB Q39G-L2N2-35-1
Q1: 8MHz; PRQC; PARTNO PRQC8.00CR1010V00L
R1, R4: 10K; R0603; PARTNO RNCP0603FTD10K0
R5, R6, R7, R8: 1K; R0603; PARTNO RMCF0603FT1K00
RESET: SPST_TACT-KMR2; KMR2; PARTNO KMR221NG
RX: YLW; CHIP-LED0603; PARTNO LTST-C191KSKT
TX: YLW; CHIP-LED0603; PARTNO LTST-C191KSKT
U1: ATMEGA32U4-XUMU; QFN44ML7X7; PARTNO ATMEGA32U4-MU

Connections:
3V3: C10.1, C11.1, L2.1, R1.1, U1.2 (UVCC), U1.14 (VCC), U1.24 (AVCC), U1.34 (VCC1); also elsewhere on the board
+5V: R5.1; also elsewhere on the board
A0: U1.36 ((ADC7/TDI)PF7); also elsewhere on the board
A1: U1.37 ((ADC6/TDO)PF6); also elsewhere on the board
A2: U1.38 ((ADC5/TMS)PF5); also elsewhere on the board
A3: U1.39 ((ADC4/TCK)PF4); also elsewhere on the board
A4: U1.40 ((ADC1)PF1); also elsewhere on the board
A5: U1.41 ((ADC0)PF0); also elsewhere on the board
AREF: C6.1, U1.42 (AREF); also elsewhere on the board
AVCC: C7.1, L2.2, U1.44 (AVCC1)
D0/RX: U1.20 ((RXD1/AIN1/INT2)PD2); also elsewhere on the board
D1/TX: U1.21 ((TXD1/INT3)PD3); also elsewhere on the board
D2/SDA: U1.19 ((SDA/INT1)PD1); also elsewhere on the board
D3/SCL: U1.18 ((OC0B/SCL/INT0)PD0); also elsewhere on the board
D4*: U1.25 ((ICP1/ADC8)PD4); also elsewhere on the board
D5*: U1.31 ((OC3A/#0C4A)PC6); also elsewhere on the board
D6*: U1.27 ((T0/OC4D/ADC10)PD7); also elsewhere on the board
D7: U1.1 ((INT6/AIN0)PE6); also elsewhere on the board
GND: C5.2, C6.2, C7.2, C10.2, C11.2, L.C, ON.C, Q1.P$2 (2), R4.2, RESET.1, RESET.3 (P1), RX.C, TX.C, U1.5 (UGND), U1.15 (GND), U1.23 (GND1), U1.35 (GND2), U1.43 (GND3), U1.EXP (PAD); also elsewhere on the board
HWB: R4.1, U1.33 ((#HWB)PE2)
IO8: U1.28 ((ADC11/PCINT4)PB4); also elsewhere on the board
IO9*: U1.29 ((PCINT5/OC1A/#OC4B/ADC12)PB5); also elsewhere on the board
IO10*: U1.30 ((PCINT6/OC1B/OC4B/ADC13)PB6); also elsewhere on the board
IO11*: U1.12 ((PCINT7/OC0A/OC1C/#RTS)PB7); also elsewhere on the board
IO12*: U1.26 ((T1/#OC4D/ADC9)PD6); also elsewhere on the board
IO13: R8.1, U1.32 ((ICP3/CLK0/OC4A)PC7); also elsewhere on the board
MISO: U1.11 ((PD0/MISO/PCINT3)PB3); also elsewhere on the board
MOSI: U1.10 ((PDI/MOSI/PCINT2)PB2); also elsewhere on the board
unnamed: R7.2, RX.A
unnamed: ON.A, R5.2
unnamed: R6.2, TX.A
unnamed: L.A, R8.2
RD+: U1.4 (D+); also elsewhere on the board
RD-: U1.3 (D-); also elsewhere on the board
RESET: R1.2, RESET.2 (S), RESET.4 (S1), U1.13 (RESET); also elsewhere on the board
RXLED/SS: R7.1, U1.8 ((SS/PCINT0)PB0); also elsewhere on the board
SCK: U1.9 ((SCLK/PCINT1)PB1); also elsewhere on the board
TXLED: R6.1, U1.22 ((XCK1/#CTS)PD5)
UCAP: C5.1, U1.6 (UCAP)
VUSB: U1.7 (VBUS); also elsewhere on the board
XTAL1: Q1.P$3 (3), U1.17 (XTAL1)
XTAL2: Q1.P$1 (1), U1.16 (XTAL2)

Notes on the sheet:
#PWM 8bit
#PWM Hi-Speed
#PWM 16bit
#PWM 10bit
#PWM 8/16bit

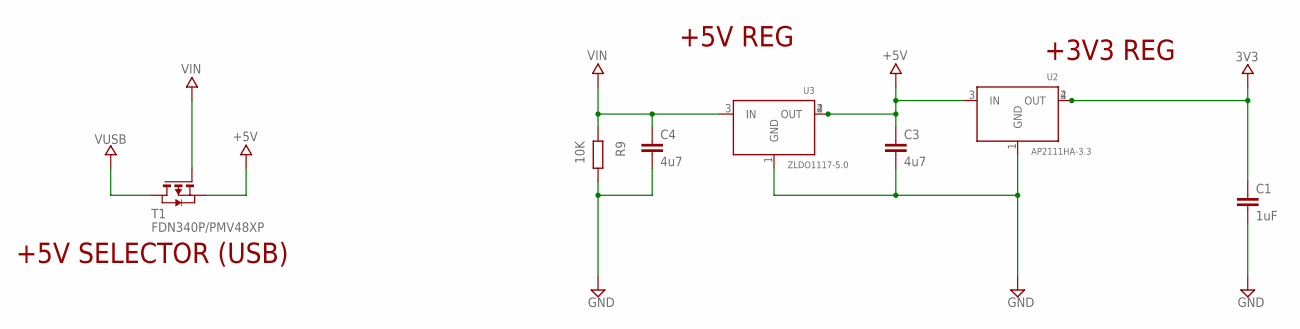
[picture p28: schematic Arachnio.sch, sheet 3]

Parts:
C1: 1uF; C0603; PARTNO C0603C105K3PACTU
C3, C4: 4u7; C0603; PARTNO CL10A475KA8NQNC
R9: 10K; R0603; PARTNO RNCP0603FTD10K0
T1: FDN340P/PMV48XP; SOT-23; PARTNO FDN340P
U2: AP2111HA-3.3; SOT223; PARTNO AP2111H-3.3TRG1
U3: ZLDO1117-5.0; SOT223

Connections:
3V3: C1.1, U2.2 (OUT), U2.4 (OUT); also elsewhere on the board
+5V: C3.1, T1.2 (S), U2.3 (IN), U3.2 (OUT), U3.4 (OUT); also elsewhere on the board
GND: C1.2, C3.2, C4.2, R9.1, U2.1 (GND), U3.1 (GND); also elsewhere on the board
VIN: C4.1, R9.2, T1.3 (G), U3.3 (IN); also elsewhere on the board
VUSB: T1.1 (D); also elsewhere on the board

Notes on the sheet:
+5V REG
+5V SELECTOR (USB)
+3V3 REG

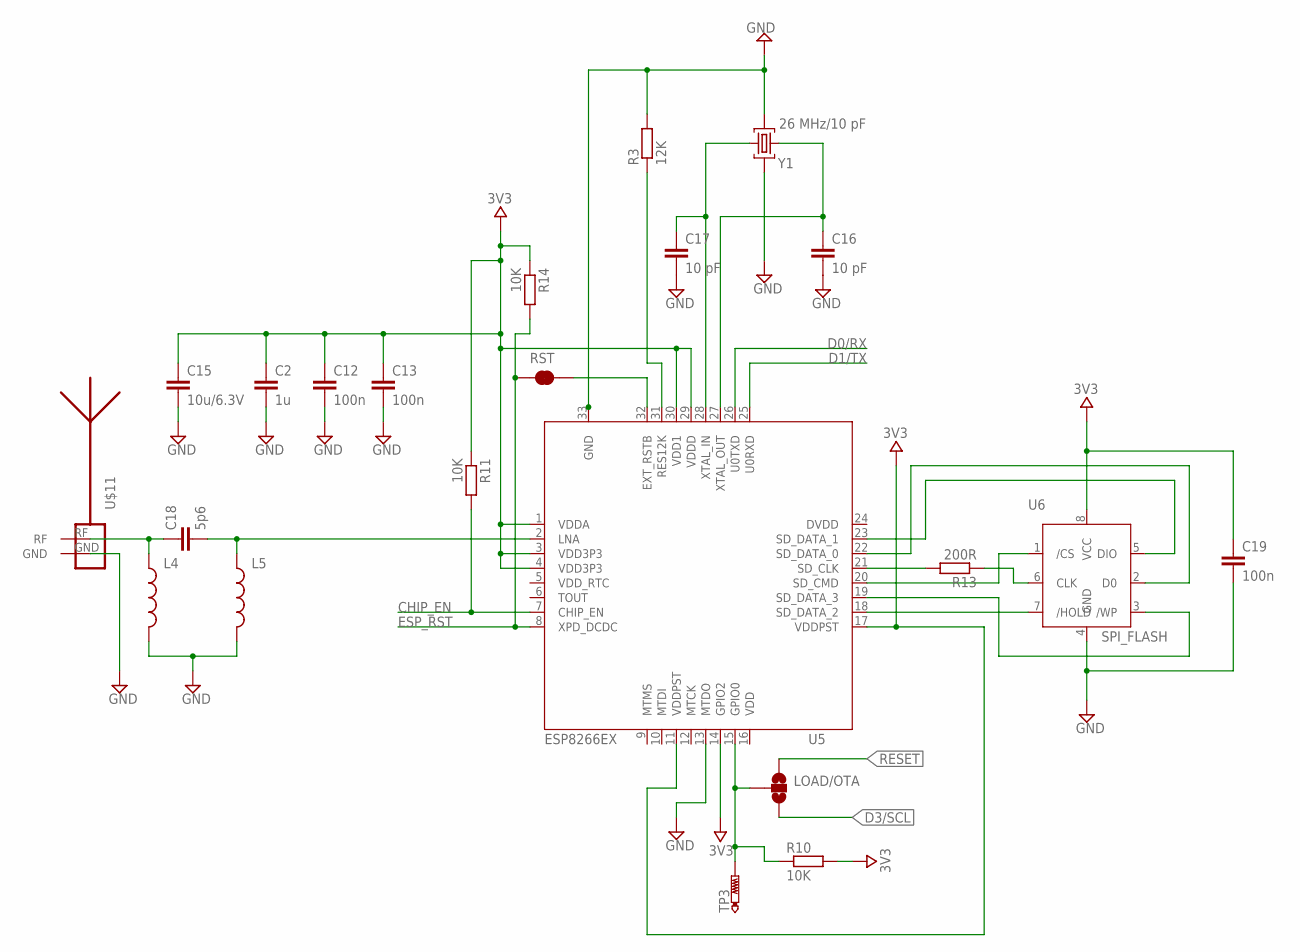
[picture p29: schematic Arachnio.sch, sheet 4]

Parts:
C2: 1u; C0603; PARTNO C0603C105K3PACTU
C12, C13, C19: 100n; C0603; PARTNO CC0603ZRY5V9BB104
C15: 10u/6.3V; C0603; PARTNO JMK107ABJ106MAHT
C16, C17: 10 pF; C0603; PARTNO C0603C100K5GACTU
C18: 5p6; C0603; PARTNO 251R14S5R6CV4T
L4, L5: INDUCTOR0603; 0603
LOAD/OTA: JUMPER-PAD-3-NOYES_SILK; PAD-JUMPER-3-NO_YES_SILK
R3: 12K; R0603; PARTNO RMCF0603FT12K0
R10, R11, R14: 10K; R0603; PARTNO RNCP0603FTD10K0
R13: 200R; R0603; PARTNO MCR03ERTJ201
RST: JUMPER-PAD-2-NC_BY_TRACE; PAD-JUMPER-2-NC_BY_TRACE_YES_SILK
TP3: PTR1TP15SQ; TP15SQ
U5: ESP8266EX; QFN32; PARTNO ESP8266EX
U6: SPI_FLASH; SOIC-8; PARTNO SST25VF512A-33-4C-SAE
U$11: ANTENNA_1RIGHT; SWRA117D_RIGHT; PARTNO *
Y1: 26 MHz/10 pF; CRYSTAL-3.2-2.5; PARTNO 403C11A26M00000

Connections:
3V3: C2.1, C12.1, C13.1, C15.1, C19.1, R10.2, R11.1, R14.1, U5.1 (VDDA), U5.3 (VDD3P3), U5.4 (VDD3P3), U5.11 (VDDPST), U5.14 (GPIO2), U5.17 (VDDPST), U5.29 (VDDD), U5.30 (VDD1), U6.8 (VCC); also elsewhere on the board
CHIP_EN: R11.2, U5.7 (CHIP_EN); also elsewhere on the board
D0/RX: U5.26 (U0TXD); also elsewhere on the board
D1/TX: U5.25 (U0RXD); also elsewhere on the board
D3/SCL: LOAD/OTA.3; also elsewhere on the board
DVDD: U5.24 (DVDD)
ESP_RST: R14.2, RST.1, U5.8 (XPD_DCDC); also elsewhere on the board
GND: C2.2, C12.2, C13.2, C15.2, C16.2, C17.2, C19.2, L4.2, L5.2, R3.2, U5.13 (MTDO), U5.33 (GND), U6.4 (GND), U$11.GND, Y1.2 (GND), Y1.4 (GND); also elsewhere on the board
unnamed: LOAD/OTA.2, R10.1, TP3.TP, U5.15 (GPIO0)
unnamed: C17.1, U5.28 (XTAL_IN), Y1.1 (C1)
unnamed: C16.1, U5.27 (XTAL_OUT), Y1.3 (C2)
unnamed: C18.1, L4.1, U$11.RF
unnamed: R3.1, U5.31 (RES12K)
unnamed: RST.2, U5.32 (EXT_RSTB)
unnamed: R13.2, U5.21 (SD_CLK)
unnamed: R13.1, U6.6 (CLK)
unnamed: U5.20 (SD_CMD), U6.1 (/CS)
unnamed: U5.18 (SD_DATA_2), U6.7 (/HOLD)
unnamed: U5.19 (SD_DATA_3), U6.3 (/WP)
unnamed: U5.23 (SD_DATA_1), U6.5 (DIO)
unnamed: U5.22 (SD_DATA_0), U6.2 (D0)
unnamed: C18.2, L5.1, U5.2 (LNA)
RESET: LOAD/OTA.1; also elsewhere on the board
VDD: U5.16 (VDD)
VDD_RTC: U5.5 (VDD_RTC)
