logos-electromechanical/Arachnio/Arachnio/hardware/Arachnio.brd

## EAGLE design Arachnio/hardware/Arachnio.brd (continued)

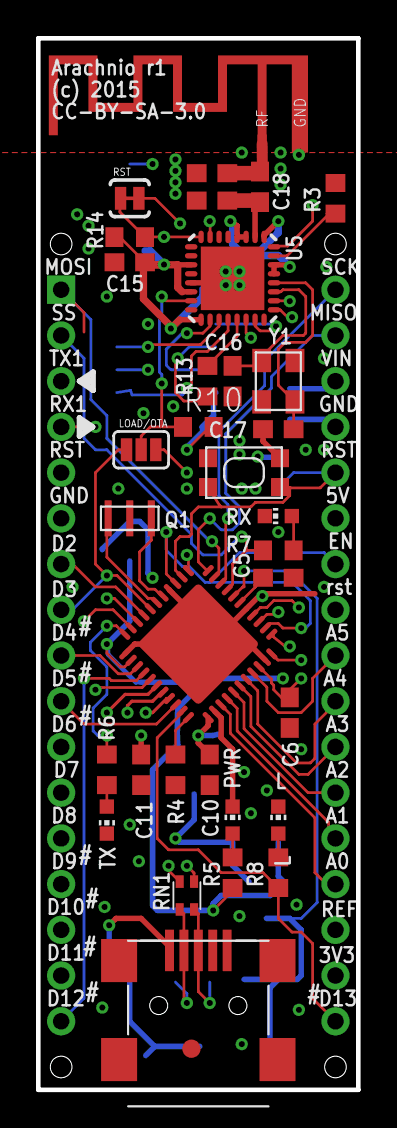
[picture p30: board Arachnio.brd from above]

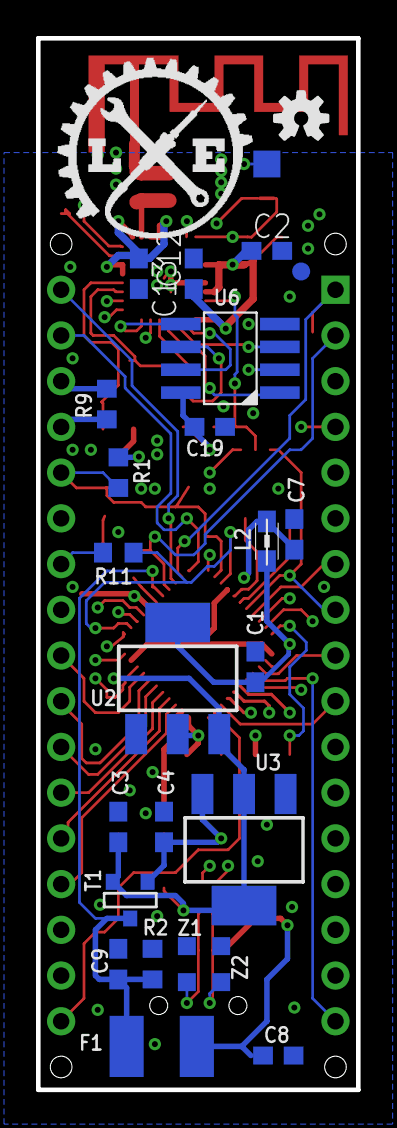
[picture p31: board Arachnio.brd from below]

Board: 4 copper layers, 17.8 x 58.4 mm, 62 parts (26 on the bottom side), 62 nets.

Other parts of the board:
U$1: LOGO-SM
U$12: OSHW-LOGO-S
