logos-electromechanical/Arachnio/(commit log)

2015-03-22 -- Re-arranged Arachnode to solve connector interference. -- Created pinout diagrams for Arachnio -- Added sketch for serial console
    [Arachnode.brd]
2015-03-22 -- Fixed missing parts designators in silkscreen
    [Arachnio.brd]
2015-03-22 -- Added mounting pads on the board -- Made reset button an independent button -- Changed all components to SMD
    [ArachnoProto.brd, ArachnoProto.sch]
2015-03-22 Sometimes eagle is silly...
    [ArachnoProto.brd]
2015-03-25 -- added power switching to make USB power work correctly. # Please enter the commit message for your changes. Lines starting # with '#' will be ignored, and an empty message aborts the commit. # On 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
    [Arachnode.brd, Arachnode.sch]
2015-04-11 Deleted an improper airwire # Please enter the commit message for your changes. Lines starting # with '#' will be ignored, and an empty message aborts the commit. # On branch master # Your branch is 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
    [ArachnoProto.brd]
2015-04-12 Added 3 new decoupling caps to the ESP8266 # Please enter the commit message for your changes. Lines starting # with '#' will be ignored, and an empty message aborts the commit. # On branch decouplin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
    [Arachnio.brd, Arachnio.sch]
2015-04-12 Added pull-up commands for GPIO 0 & 2 to enable correct booting This will get a hardware fix on the next board # Please enter the commit message for your changes. Lines starting # with '#' will be ig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
    [ArachnioSerialConsole.ino]
2015-04-18 Made some updates while diagnosing prototype issues
    [ArachnioSerialConsole.ino]
2015-04-18 -- Fixed ground plane issues -- Connected USB shield to ground -- Simplified boot select by tying MTDO and GPIO2 low and high, respectively -- Removed test points for MTDO and GPIO2 -- Replaced 0R re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
    [Arachnio.brd, Arachnio.sch]
2015-05-03 Started branch for ArachnioDue (ATSAM3S*A*-MU processor)
    [ArachnioDue.brd, ArachnioDue.sch]
2015-05-03 Added a null sketch for flashing code to the ESP via external device
2015-05-03 Checking in last Gerber files for the decoupling branch
    [Arachnio.GBL, Arachnio.GBO, Arachnio.GBS, Arachnio.GTL, Arachnio.GTO, Arachnio.GTS, Arachnio.gko]
2015-05-03 -- Checking in sam tree copied from Arduino Due. -- Modified makefiles and boards.txt to accomodate the Arachnio Due (currently UNTESTED!!!) -- Checked in some ESP documentation
2015-05-04 -- Captured schematic for SAM3S*A version
    [ArachnioDue.brd, ArachnioDue.sch]
2015-05-14 First test boards of this design # Please enter the commit message for your changes. Lines starting # with '#' will be ignored, and an empty message aborts the commit. # On branch master # Your branc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
    [ArachnioDue.brd, ArachnioDue.sch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]
2015-08-19 Pre-prototype check-in
    [ArachnioDue.brd, ArachnioDue.sch]
2015-10-17 Moved the Arachnode connectors around for USB clearance.
    [Arachnode.brd]
