logos-electromechanical/Arachnio/(notices)

Notices in the files:
Arachnio/hardware/Arachnio.brd:
(c) 2015
CC-BY-SA-3.0
parts and their libraries:
SparkFun-Connectors: Licensing: Creative Commons ShareAlike 4.0 International - https://creativecommons.org/licenses/by-sa/4.0
SparkFun-Aesthetics: Licensing: CC v3.0 Share-Alike You are welcome to use this library for commercial purposes.
